dadanugm/hackster_junkdrawer/PCB_Main_Board_ESP32S3_RFM95/PCB_Main_Board_ESP32S3_RFM95.kicad_pcb

## KiCad design PCB_Main_Board_ESP32S3_RFM95/PCB_Main_Board_ESP32S3_RFM95.kicad_pcb (2024-12-31)

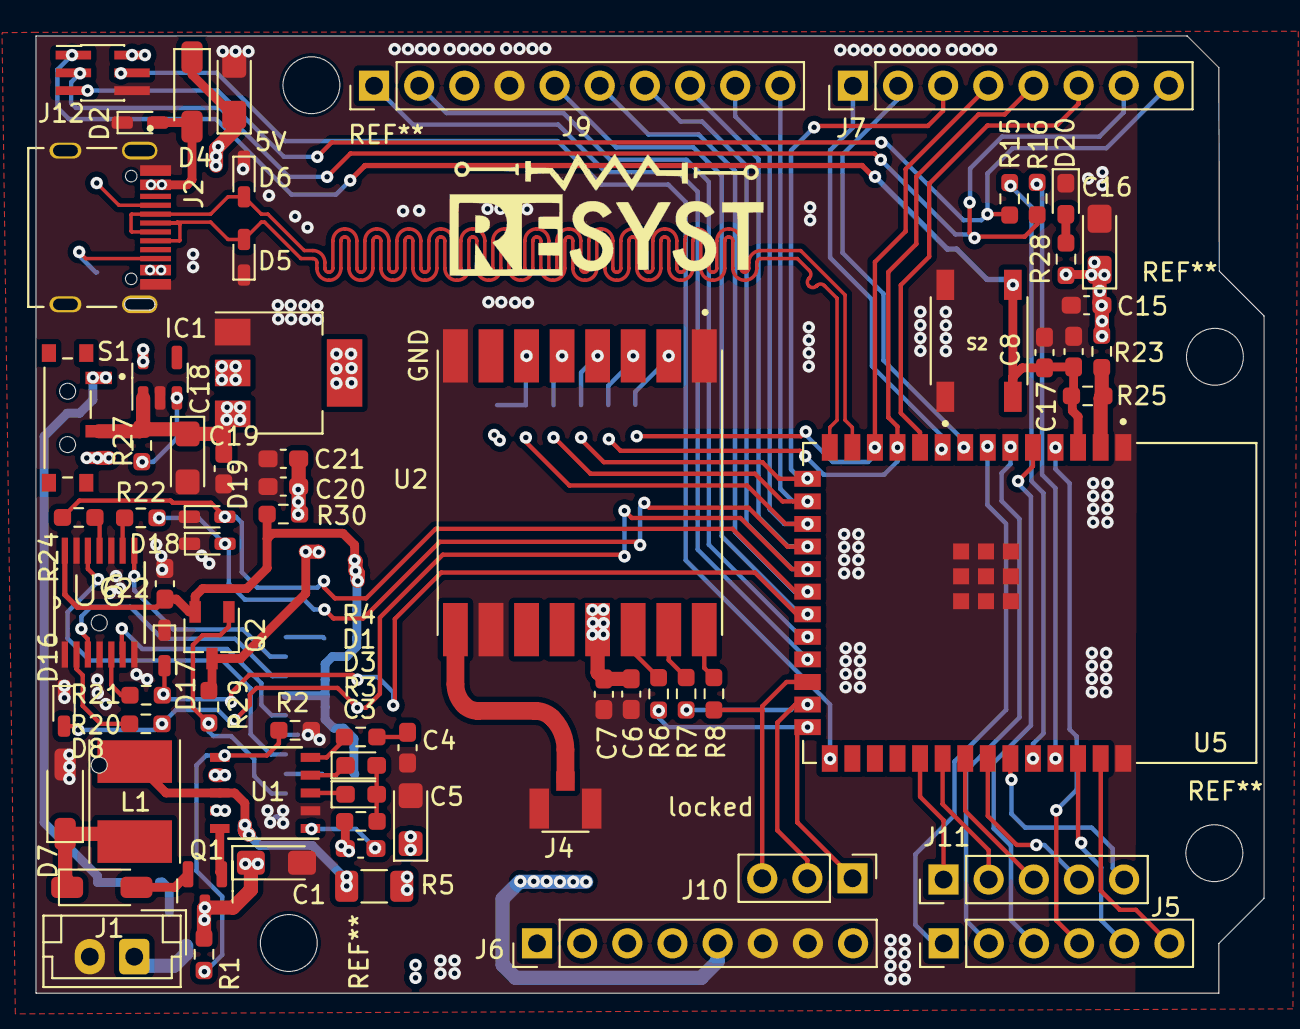
[picture p1: board PCB_Main_Board_ESP32S3_RFM95.kicad_pcb from above]

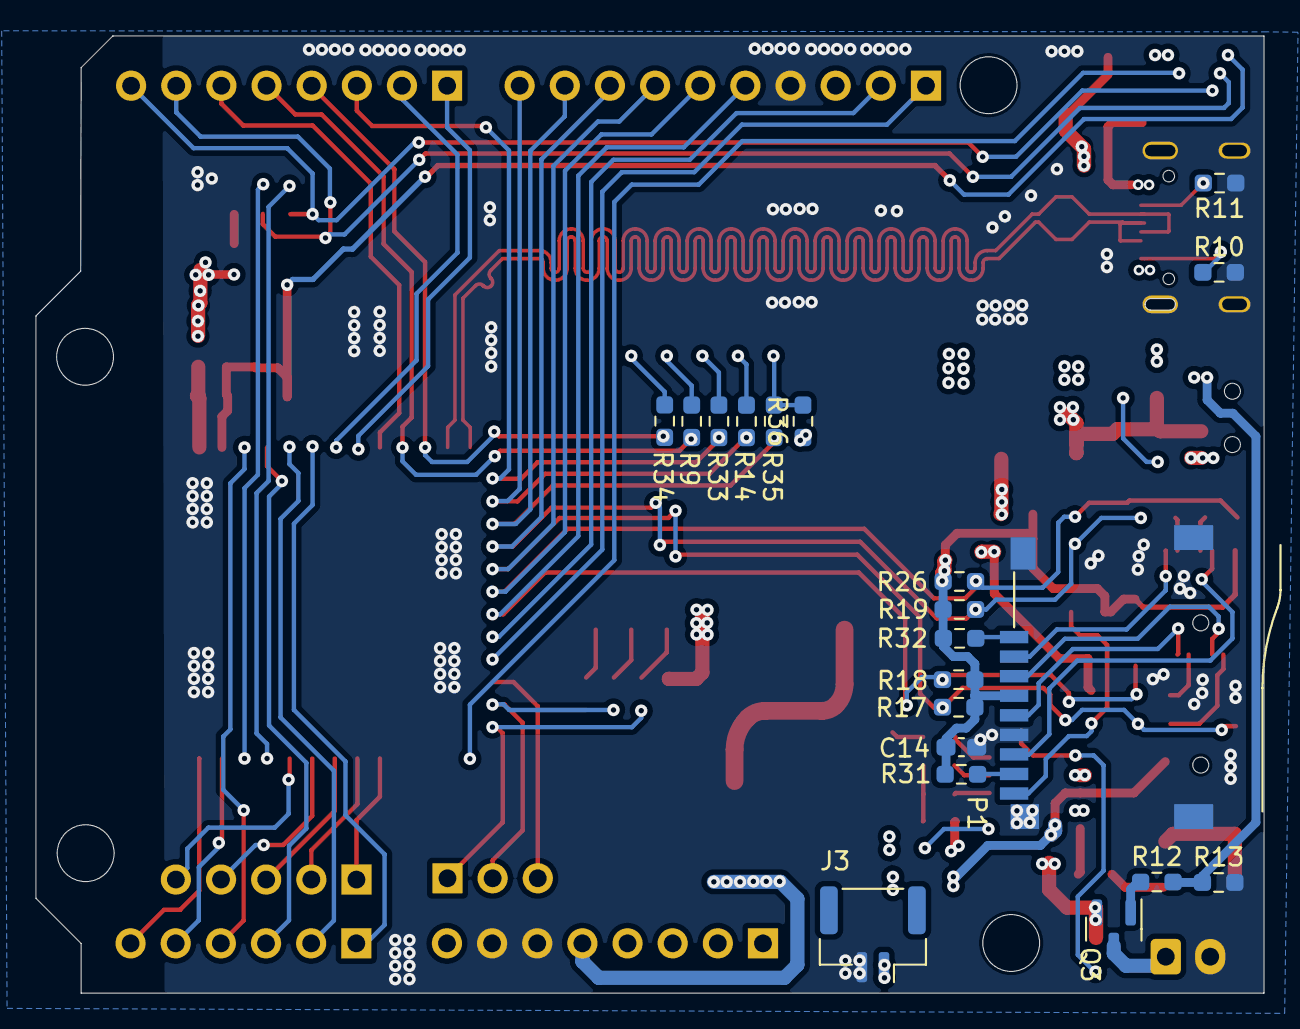
[picture p2: board PCB_Main_Board_ESP32S3_RFM95.kicad_pcb from below]

Board: 4 copper layers, 69.1 x 53.8 mm, 90 parts (20 on the bottom side), 81 nets.

Parts:
C1: 10uF; CP_EIA-3216-18_Kemet-A_Pad1.58x1.35mm_HandSolder
C2, C16: 10uF/25V Tantalum; CP_EIA-3216-18_Kemet-A_Pad1.58x1.35mm_HandSolder
C3, C4, C6, C8, C14, C15, C21, C22: 100nf; C_0603_1608Metric_Pad1.08x0.95mm_HandSolder
C5: 1uF; CP_EIA-3216-18_Kemet-A
C7: 1uf; C_0603_1608Metric_Pad1.08x0.95mm_HandSolder
C17: 1uF; C_0603_1608Metric_Pad1.08x0.95mm_HandSolder
C18: CP1; CP_EIA-3216-18_Kemet-A
C19, C20: 470pf; C_0603_1608Metric_Pad1.08x0.95mm_HandSolder
D1, D3, D20: LED; LED_0603_1608Metric_Pad1.05x0.95mm_HandSolder
D2, D5, D6: LESD5D5.0CT1G; D_SOD-523
D4, D7, D8: 1N5819WS; D_SOD-123
D16, D17, D18, D19: D_TVS; D_SOD-523
IC1: ME6211; SOT-23-5
J1: Conn_01x02_Male; JST_EH_B2B-EH-A_1x02_P2.50mm_Vertical
J2: USB-C; USB-C-2
J3: Conn_01x02_Male; JST_GH_SM02B-GHS-TB_1x02-1MP_P1.25mm_Horizontal
J4: UFL; UFL_CONN
J5: Analog_Pin; PinHeader_1x06_P2.54mm_Vertical
J6: Power_Pin; PinHeader_1x08_P2.54mm_Vertical
J7: Dig_Pin_0-7; PinHeader_1x08_P2.54mm_Vertical
J9: Dig_Pin_8-18; PinHeader_1x10_P2.54mm_Vertical
J10: Conn_01x03; PinHeader_1x03_P2.54mm_Vertical
J11: Conn_01x05_Pin; PinHeader_1x05_P2.54mm_Vertical
J12: Conn_02x03_Odd_Even; PinHeader_2x03_P1.00mm_Vertical_SMD
L1: L; L_Taiyo-Yuden_NR-50xx_HandSoldering
P1: MICRO_SD_Socket; MicroSD_Footprints
Q1: Q_PNP_BEC; SOT-23
Q2: Q_PMOS_GDS; TSOT-23
Q3: AO3401A; SOT-23
R1, R12, R13, R17, R18, R19, R25, R26, R36: 10K; R_0603_1608Metric_Pad0.98x0.95mm_HandSolder
R2, R3, R6, R7, R8, R9, R10, R11, R14, R20, R21, R22, R24, R33, R34, R35: 3.3K; R_0603_1608Metric_Pad0.98x0.95mm_HandSolder
R4: 120; R_0603_1608Metric_Pad0.98x0.95mm_HandSolder
R5: RS 50; R_1206_3216Metric_Pad1.30x1.75mm_HandSolder
R15, R16, R28: 22; R_0603_1608Metric_Pad0.98x0.95mm_HandSolder
R23: 0; R_0603_1608Metric_Pad0.98x0.95mm_HandSolder
R27: 1M; R_0603_1608Metric_Pad0.98x0.95mm_HandSolder
R29, R31, R32: 10k; R_0603_1608Metric_Pad0.98x0.95mm_HandSolder
R30: NM/BYPASS; R_0603_1608Metric_Pad0.98x0.95mm_HandSolder
S1: EG1215AA; SW_Slide_SPST_Side
S2: SW_Tactile
U1: CN3791; SSOP-10_3.9x4.9mm_P1.00mm
U2: RFM95W; RFM95
U5: ESP32-S3-WROOM-1-N8R8; ESP32S3_WROOM_1N8R8
U6: 74LVC125A
U7: SGM2212; SOT-223-3_TabPin2

Connections:
/5V: C2.1, D4.1 (K), R12.2, R13.1, S1.1
/ESP32S3_Minsys/3V3: C6.2, C7.2, C15.2, C16.1, C20.2, C21.2, IC1.5 (VOUT), J6.4, J12.2, Q2.3 (S), R23.2, R28.1, R29.1, R30.1, R36.1, U2.13 (3.3V), U7.2 (VO)
/ESP32S3_Minsys/ANT: J4.3 (SIG), U2.9 (ANT)
/ESP32S3_Minsys/CHIP_PU: C8.1, C17.2, J12.1, R25.1, S2.3, S2.4, U5.3 (EN)
/ESP32S3_Minsys/ESP_3V3: R23.1, R25.2, U5.2 (3V3)
/ESP32S3_Minsys/ESP_RXD: J7.8, J12.5, R15.1
/ESP32S3_Minsys/ESP_TXD: J7.7, J12.3, R16.1
/ESP32S3_Minsys/GPIO_0: J12.4, U5.27 (IO0)
/ESP32S3_Minsys/GPIO_38: J11.1, U5.31 (IO38)
/ESP32S3_Minsys/IO3/D5: J7.3, R33.2, U5.15 (IO3)
/ESP32S3_Minsys/IO4/A5: J5.6, U5.39 (IO1)
/ESP32S3_Minsys/IO5/A4: J5.5, U5.38 (IO2)
/ESP32S3_Minsys/IO6/A3: J5.4, U5.4 (IO4)
/ESP32S3_Minsys/IO7/A2: J5.3, U5.5 (IO5)
/ESP32S3_Minsys/IO8/D4: J7.4, R34.2, U5.12 (IO8)
/ESP32S3_Minsys/IO9/D9: J9.9, R35.2, U5.17 (IO9)
/ESP32S3_Minsys/IO10/D10: D18.2 (A2), J9.8, R19.2, R22.2, U5.18 (IO10)
/ESP32S3_Minsys/IO11/D11/ESP_MOSI: D16.2 (A2), J9.7, R17.2, R20.2, U5.19 (IO11)
/ESP32S3_Minsys/IO12/D12/ESP_MISO: D19.2 (A2), J9.6, R24.2, R26.2, U5.20 (IO12)
/ESP32S3_Minsys/IO13/D13/ESP_SCK: D17.2 (A2), J9.5, R18.2, R21.2, U5.21 (IO13)
/ESP32S3_Minsys/IO14/D14/ESP_I2C_SDA: J9.2, U5.22 (IO14)
/ESP32S3_Minsys/IO15: J7.2, U5.8 (IO15)
/ESP32S3_Minsys/IO15/A1: J5.2, U5.6 (IO6)
/ESP32S3_Minsys/IO15/D15/ESP_I2C_SCL: J9.1, U5.23 (IO21)
/ESP32S3_Minsys/IO16: J7.1, U5.9 (IO16)
/ESP32S3_Minsys/IO16/A0: J5.1, U5.7 (IO7)
/ESP32S3_Minsys/IO17/D2: J7.6, U5.10 (IO17)
/ESP32S3_Minsys/IO18/D3: J7.5, R9.1, U5.11 (IO18)
/ESP32S3_Minsys/IO39: J11.2, U5.32 (IO39)
/ESP32S3_Minsys/IO40: J11.3, U5.33 (IO40)
/ESP32S3_Minsys/IO41: J11.4, U5.34 (IO41)
/ESP32S3_Minsys/IO42: J11.5, U5.35 (IO42)
/ESP32S3_Minsys/IO45: J10.1, R6.2, U5.26 (IO45)
/ESP32S3_Minsys/IO46/D8: J9.10, R14.2, U5.16 (IO46)
/ESP32S3_Minsys/IO47: J10.3, R8.2, U5.24 (IO47)
/ESP32S3_Minsys/IO48: J10.2, R7.2, U5.25 (IO48)
/ESP32S3_Minsys/RST_RFM: R35.1, R36.2, U2.6 (RESET)
/ESP32S3_Minsys/SD_DET: P1.9 (CD), Q2.1 (G), R29.2
/ESP32S3_Minsys/SD_VCC: C14.2, C22.2, P1.4 (VDD), Q2.2 (D), R17.1, R18.1, R19.1, R26.1, R30.2, R31.1, R32.1, U6.14 (VCC)
/ESP32S3_Minsys/SPI_CLK: P1.5 (SPI_CLK), U6.6 (2Y)
/ESP32S3_Minsys/SPI_CS: P1.2 (SPI_CS), U6.8 (3Y)
/ESP32S3_Minsys/SPI_MISO: P1.7 (SPI_MISO), U6.12 (4A)
/ESP32S3_Minsys/SPI_MOSI: P1.3 (SPI_MOSI), U6.3 (1Y)
/U1_N: D6.2 (A2), J2.A7 (DN1), J2.B7 (DN2), U5.13 (IO19)
/U1_P: D5.2 (A2), J2.A6 (DP1), J2.B6 (DP2), U5.14 (IO20)
/VBAT: C5.1, J3.1, R5.1, S1.3, U1.7 (BAT)
/VBUS: C1.1, C3.1, D2.2 (A2), D4.2 (A), J2.A4 (VBUS_A), J2.A9 (VBUS_A), J2.B4 (VBUS_B), J2.B9 (VBUS_B), Q1.3 (C), Q3.2 (S), R1.1, R3.1, U1.9 (VCC)
/VIN: C18.1, C19.2, IC1.1 (VIN), J6.5, R27.2, S1.2, U7.3 (VI)
GND: C1.2, C2.2, C4.2, C5.2, C6.1, C7.1, C8.2, C14.1, C15.1, C16.2, C17.1, C18.2, C19.1, C20.1, C21.1, C22.1, D2.1 (A1), D5.1 (A1), D6.1 (A1), D8.2 (A), D16.1 (A1), D17.1 (A1), D18.1 (A1), D19.1 (A1), D20.1 (K), IC1.2 (GND), J1.2, J2.A1 (GND_A), J2.A12 (GND_A), J2.B1 (GND_B), J2.B12 (GND_B), J2.S1 (SHELL_GND), J2.S2 (SHELL_GND), J2.S3 (SHELL_GND), J2.S4 (SHELL_GND), J3.2, J4.1 (GND), J4.2 (GND), J6.6, J6.7, J9.4, J12.6, P1.6 (GND), P1.G1 (GND), P1.G2 (GND), P1.G3 (GND), P1.G4 (GND), R2.2, R10.2, R11.1, R13.2, S2.1, S2.2, U1.2 (GND), U2.1 (GND), U2.8 (GND), U2.10 (GND), U5.1 (GND), U5.40 (GND), U5.41_1 (GND), U5.41_2 (GND), U5.41_3 (GND), U5.41_4 (GND), U5.41_5 (GND), U5.41_6 (GND), U5.41_7 (GND), U5.41_8 (GND), U5.41_9 (GND), U6.1 (1~OE), U6.4 (2~OE), U6.7 (GND), U6.10 (3~OE), U6.13 (4~OE), U7.1 (ADJ)
unnamed: C4.1, R4.1
unnamed: D1.2 (A), D3.2 (A), R3.2
unnamed: D1.1 (K), U1.4 (DONE)
unnamed: D3.1 (K), U1.3 (CHRG)
unnamed: D7.2 (A), Q1.2 (E)
unnamed: D7.1 (K), D8.1 (K), L1.1
unnamed: D20.2 (A), R28.2
unnamed: IC1.3 (CE), R27.1
unnamed: J1.1, Q3.3 (D)
unnamed: J2.A5 (CC1), R11.2
unnamed: J2.B5 (CC2), R10.1
unnamed: P1.8 (DAT1), R31.2
unnamed: P1.1 (DAT2), R32.2
unnamed: Q1.1 (B), U1.10 (DRV)
unnamed: Q3.1 (G), R12.1
unnamed: R4.2, U1.5 (COM)
unnamed: L1.2, R5.2, U1.8 (CSP)
unnamed: R1.2, R2.1, U1.6 (MPPT)
unnamed: C3.2, U1.1 (VG)
unnamed: R6.1, U2.14 (DIO0)
unnamed: R7.1, U2.15 (DIO1)
unnamed: R8.1, U2.16 (DIO2)
unnamed: R34.1, U2.2 (MISO)
unnamed: R9.2, U2.3 (MOSI)
unnamed: R14.1, U2.5 (NSS)
unnamed: R33.1, U2.4 (SCK)
unnamed: R15.2, U5.36 (RXD0)
unnamed: R16.2, U5.37 (TXD0)
unnamed: R20.1, U6.2 (1A)
unnamed: R21.1, U6.5 (2A)
unnamed: R22.1, U6.9 (3A)
unnamed: R24.1, U6.11 (4Y)
