dadanugm/hackster_junkdrawer/ESP32S3_Lorawan/ESP32S3_Lorawan.ino

/*******************************************************************************
 * Copyright (c) 2015 Thomas Telkamp and Matthijs Kooijman
 * Copyright (c) 2018 Terry Moore, MCCI
 *
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
 * This example sends a valid LoRaWAN packet with payload "Hello,
 * world!", using frequency and encryption settings matching those of
 * the The Things Network.
 *
 * This uses OTAA (Over-the-air activation), where where a DevEUI and
 * application key is configured, which are used in an over-the-air
 * activation procedure where a DevAddr and session keys are
 * assigned/generated for use with all further communication.
 *
 * Note: LoRaWAN per sub-band duty-cycle limitation is enforced (1% in
 * g1, 0.1% in g2), but not the TTN fair usage policy (which is probably
 * violated by this sketch when left running for longer)!

 * To use this sketch, first register your application and device with
 * the things network, to set or generate an AppEUI, DevEUI and AppKey.
 * Multiple devices can use the same AppEUI, but each device has its own
 * DevEUI and AppKey.
 *
 * Do not forget to define the radio type correctly in
 * arduino-lmic/project_config/lmic_project_config.h or from your BOARDS.txt.
 *
 *******************************************************************************/

#include <lmic.h>
#include <hal/hal.h>
#include <SPI.h>

//
// For normal use, we require that you edit the sketch to replace FILLMEIN
// with values assigned by the TTN console. However, for regression tests,
// we want to be able to compile these scripts. The regression tests define
// COMPILE_REGRESSION_TEST, and in that case we define FILLMEIN to a non-
// working but innocuous value.
//
#ifdef COMPILE_REGRESSION_TEST
# define FILLMEIN 0
#else
# warning "You must replace the values marked FILLMEIN with real values from the TTN control panel!"
# define FILLMEIN (#dont edit this, edit the lines that use FILLMEIN)
#endif

#ifdef CORE_DEBUG_LEVEL
#undef CORE_DEBUG_LEVEL
#endif

#define CORE_DEBUG_LEVEL 3
#define LOG_LOCAL_LEVEL ESP_LOG_DEBUG

#define RFM_MISO 8
#define RFM_MOSI 18
#define RFM_SCK  3
#define RFM_SS   46
#define RFM_RST  9

#define SD_MISO 26
#define SD_MOSI 27
#define SD_SCLK 25
#define SD_SS   32

#define DI0 45
#define DI1 48
#define DI2 47

static const char *TAG = "ino";
// This EUI must be in little-endian format, so least-significant-byte
// first. When copying an EUI from ttnctl output, this means to reverse
// the bytes. For TTN issued EUIs the last bytes should be 0xD5, 0xB3,
// 0x70.
static const u1_t PROGMEM APPEUI[8]={ 0x01, 0x00, 0x00, 0x00, 0x00, 0x00, 0x00, 0x00 };
void os_getArtEui (u1_t* buf) { memcpy_P(buf, APPEUI, 8);}

// This should also be in little endian format, see above.
static const u1_t PROGMEM DEVEUI[8]={ 0x01, 0x00, 0x00, 0x00, 0x00, 0x00, 0x00, 0x00 };
void os_getDevEui (u1_t* buf) { memcpy_P(buf, DEVEUI, 8);}

// This key should be in big endian format (or, since it is not really a
// number but a block of memory, endianness does not really apply). In
// practice, a key taken from ttnctl can be copied as-is.
static const u1_t PROGMEM APPKEY[16] = { 0x00, 0x00, 0x00, 0x00, 0x00, 0x00, 0x00, 0x00, 0x00, 0x00, 0x00, 0x00, 0x00, 0x00, 0x00, 0x01 };
void os_getDevKey (u1_t* buf) {  memcpy_P(buf, APPKEY, 16);}

static uint8_t mydata[] = "Hello, world!";
static osjob_t sendjob;

// Schedule TX every this many seconds (might become longer due to duty
// cycle limitations).
const unsigned TX_INTERVAL = 60;
u1_t frame_buff[255];
// Pin mapping
const lmic_pinmap lmic_pins = {
    .nss = RFM_SS,
    .rxtx = LMIC_UNUSED_PIN,
    .rst = RFM_RST,
    .dio = {DI0, DI1, DI2},
};

void onEvent (ev_t ev) {
    ESP_LOGI(TAG, "%i", os_getTime());
    switch(ev) {
        case EV_SCAN_TIMEOUT:
            ESP_LOGI(TAG, "EV_SCAN_TIMEOUT");
            break;
        case EV_BEACON_FOUND:
            ESP_LOGI(TAG, "EV_BEACON_FOUND");
            break;
        case EV_BEACON_MISSED:
            ESP_LOGI(TAG, "EV_BEACON_MISSED");
            break;
        case EV_BEACON_TRACKED:
            ESP_LOGI(TAG, "EV_BEACON_TRACKED");
            break;
        case EV_JOINING:
            ESP_LOGI(TAG, "EV_JOINING");
            break;
        case EV_JOINED:
            ESP_LOGI(TAG, "EV_JOINED");
            {
              u4_t netid = 0;
              devaddr_t devaddr = 0;
              u1_t nwkKey[16];
              u1_t artKey[16];
              LMIC_getSessionKeys(&netid, &devaddr, nwkKey, artKey);
              ESP_LOGI(TAG, "netid: %x", netid);
              ESP_LOGI(TAG, "devaddr: %x", devaddr);
              ESP_LOGI(TAG, "AppSKey: %x", artKey);
              ESP_LOGI(TAG, "NwkSKey: %x", nwkKey);
            }
            // Disable link check validation (automatically enabled
            // during join, but because slow data rates change max TX
	    // size, we don't use it in this example.
            LMIC_setLinkCheckMode(0);
            break;
        /*
        || This event is defined but not used in the code. No
        || point in wasting codespace on it.
        ||
        || case EV_RFU1:
        ||     ESP_LOGI(F("EV_RFU1"));
        ||     break;
        */
        case EV_JOIN_FAILED:
            ESP_LOGI(TAG, "EV_JOIN_FAILED");
            break;
        case EV_REJOIN_FAILED:
            ESP_LOGI(TAG, "EV_REJOIN_FAILED");
            break;
        case EV_TXCOMPLETE:
            ESP_LOGI(TAG, "EV_TXCOMPLETE (includes waiting for RX windows)");
            if (LMIC.txrxFlags & TXRX_ACK)
              ESP_LOGI(TAG, "Received ack");
            if (LMIC.dataLen) {
              ESP_LOGI(TAG, "Received : %i bytes of payload", LMIC.dataLen);
              for (int i=0; i < LMIC.dataLen; i++){
                frame_buff[i] = (LMIC.frame[LMIC.dataBeg+i]);
              }
              ESP_LOGI(TAG, "Frame: %s", frame_buff);
            }
            // Schedule next transmission
            os_setTimedCallback(&sendjob, os_getTime()+sec2osticks(TX_INTERVAL), do_send);
            break;
        case EV_LOST_TSYNC:
            ESP_LOGI(TAG, "EV_LOST_TSYNC");
            break;
        case EV_RESET:
            ESP_LOGI(TAG, "EV_RESET");
            break;
        case EV_RXCOMPLETE:
            // data received in ping slot
            ESP_LOGI(TAG, "EV_RXCOMPLETE");
            break;
        case EV_LINK_DEAD:
            ESP_LOGI(TAG, "EV_LINK_DEAD");
            break;
        case EV_LINK_ALIVE:
            ESP_LOGI(TAG, "EV_LINK_ALIVE");
            break;
        /*
        || This event is defined but not used in the code. No
        || point in wasting codespace on it.
        ||
        || case EV_SCAN_FOUND:
        ||    ESP_LOGI(F("EV_SCAN_FOUND"));
        ||    break;
        */
        case EV_TXSTART:
            ESP_LOGI(TAG, "EV_TXSTART");
            break;
        case EV_TXCANCELED:
            ESP_LOGI(TAG, "EV_TXCANCELED");
            break;
        case EV_RXSTART:
            /* do not print anything -- it wrecks timing */
            break;
        case EV_JOIN_TXCOMPLETE:
            ESP_LOGI(TAG, "EV_JOIN_TXCOMPLETE: no JoinAccept");
            break;

        default:
            ESP_LOGI(TAG, "Unknown event: %i", ((unsigned) ev));
            break;
    }
}

void do_send(osjob_t* j){
    // Check if there is not a current TX/RX job running
    ESP_LOGI(TAG, "do send job");
    if (LMIC.opmode & OP_TXRXPEND) {
        ESP_LOGI(TAG, "OP_TXRXPEND, not sending");
    } else {
        // Prepare upstream data transmission at the next possible time.
        LMIC_setTxData2(1, mydata, sizeof(mydata)-1, 0);
        ESP_LOGI(TAG, "Packet queued");
    }
    // Next TX is scheduled after TX_COMPLETE event.
}

void setup() {
    //Serial.begin(115200, SERIAL_8N1, USB_RXD, USB_TXD);
    Serial.begin(115200);
    Serial.println(F("Starting"));
    delay(1);
    esp_log_level_set(TAG, ESP_LOG_INFO);
    ESP_LOGI(TAG, "LOG_I");
    delay(1);
    ESP_LOGI(TAG, "SPI INIT");
    SPI.begin(RFM_SCK, RFM_MISO, RFM_MOSI, RFM_SS);
    pinMode(RFM_SS, OUTPUT);
    // LMIC init
    ESP_LOGI(TAG, "OS INIT");
    os_init();
    // Reset the MAC state. Session and pending data transfers will be discarded.
    LMIC_reset();

    // Start job (sending automatically starts OTAA too)
    do_send(&sendjob);
}

void loop() {
    os_runloop_once();
}
